sohams-MASS/AVCC_Electronics/AVCC_Architecture.pdf

# AVCC Electronics System Architecture

Detailed Technical Reference

Platform: ESP32 (Espressif, Arduino Core 2.0.14 / ESP-IDF 5.x) Protocol: ESP-NOW (250 kbps, 250 byte max payload) Topology: 1 Master + 3 Slaves (star)
Channels: 12 per slave (36 total outputs)

Generated March 8, 2026

AVCC Electronics | System Architecture

## Contents

1 System Overview | 2
2 Wire Protocol | 3
3 Master Controller | 4
4 Electrical Slave | 7
5 Pressure Slave | 10
6 Servo Slave | 11
7 Synchronization and Timing | 13

8 Safety Mechanisms | 14
9 Memory and Performance | 14
10 Utility Sketches | 15
11 Complete File Reference | 15
12 Appendix: MAC Addresses (Current Configuration) | 15

## 1 System Overview

The AVCC (Autonomous Vascular Compression Controller) Electronics system is a real-time, wireless, multi-channel waveform controller built on four ESP32 microcontrollers connected via ESP-NOW. It drives three different output modalities—analog voltage (electrical), digital solenoid (pressure), and servo motor—synchronized from a single master controller.

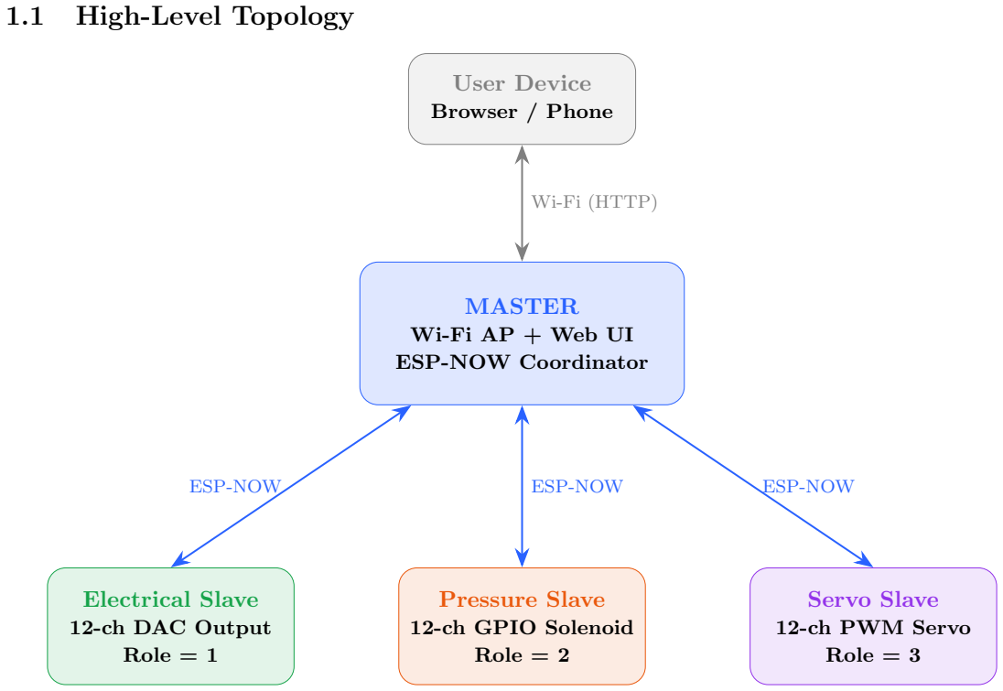
[picture p1: figure]
1.1 High-Level Topology; MASTER; Wi-Fi AP + Web UI ESP-NOW Coordinator; Electrical Slave; 12-ch DAC Output; Role = 1; Pressure Slave; 12-ch GPIO Solenoid Role = 2; Servo Slave; 12-ch PWM Servo Role = 3; ESP-NOW; User Device; Browser / Phone; Wi-Fi (HTTP)

### 1.2 Communication Flow Summary

1. User connects to the Master’s Wi-Fi AP (AVCC Master 5, password 12345678) and opens http://192.168.4.1.
2. Master serves a streamed HTML control page where the user configures 12 channels (frequency, pulse width, amplitude, pressure duration, phase offsets).
3. On Apply + Start, the Master enters the MS WAIT ACKS state, burst-sends CMD SET messages for all 12 channels to all 3 slaves, followed by targeted CMD START messages.
4. Each Slave receives messages via a FreeRTOS queue, applies per-channel configuration, and sends back AckMsg (0xA1) confirmations.
5. During operation (MS RUNNING), the Master sends CMD KEEPALIVE at 6.7 Hz. Slaves auto-stop if no keepalive arrives within 500 ms.
6. Slaves send StatusMsg (0xA2) at 1 Hz with health telemetry (heap, heartbeat age, sequence watermark).

## 2 Wire Protocol

All messages are sent as raw ESP-NOW payloads. Structs use attribute ((packed)) to eliminate padding and guarantee byte-exact layout across devices.

### 2.1 Command Message (Msg) — Master → Slaves

Field | Type | Offset | Description
cmd | uint8 t | 0 | Command code (1–4)
ch | uint8 t | 1 | Channel 1–12 (0 = all)
flags | uint8 t | 2 | Bitfield (see below)
neutral code | uint8 t | 3 | DAC neutral code (0x80)
run id | uint32 t | 4 | Monotonic run identifier
seq | uint32 t | 8 | Per-channel sequence number
period us | uint32 t | 12 | Full cycle period (µs)
pulse us | uint32 t | 16 | Pulse width (µs)
pos code | uint8 t | 20 | Positive DAC code
neg code | uint8 t | 21 | Negative DAC code
rsv0 | uint8 t | 22 | Reserved
rsv1 | uint8 t | 23 | Reserved
start delay us | uint32 t | 24 | Sync start delay (µs)
phase offset us | uint32 t | 28 | Phase offset (µs)
duration ms | uint32 t | 32 | Run duration (ms); 0 = forever

Total size: 36 bytes (V3). The legacy V1 format is 24 bytes (no start delay us, phase offset us, duration ms). Pressure and Servo slaves auto-detect V1 by checking len == sizeof(MsgV1).

### 2.1.1 Command Codes

Value | Name | Description
1 | CMD SET | Configure channel parameters (period, pulse,
amplitude). Does not start output.
2 | CMD START | Begin waveform output. | Carries start delay,
phase offset, and duration.
3 | CMD STOP | Immediately stop all channels and park outputs
at safe state.
4 | CMD KEEPALIVE | Heartbeat ping. | Resets each slave’s failsafe
timer.

### 2.1.2 Flag Bits

Bit | Constant | Meaning
0 | FLG SET MIRROR (0x01) Mirror waveform around neutral (electrical only)
1 | FLG TGT ELEC (0x02) | START targets the Electrical slave
2 | FLG TGT PRES (0x04) | START targets the Pressure slave
3 | FLG TGT MOTO (0x08) | START targets the Servo slave

### 2.2 Acknowledgment Message (AckMsg) — Slaves → Master

Field | Type | Offset | Description
type | uint8 t | 0 | Always 0xA1
role | uint8 t | 1 | 1=Electrical, 2=Pressure, 3=Motor
cmd | uint8 t | 2 | Echoed command code
ch | uint8 t | 3 | Echoed channel (0 for STOP)
run id | uint32 t | 4 | Echoed run ID
seq | uint32 t | 8 | Echoed sequence number
ok | uint8 t | 12 | 1 = accepted, 0 = rejected
rsv[3] uint8 t | 13 | Reserved padding

Total size: 16 bytes.

### 2.3 Status Message (StatusMsg) — Slaves → Master

Field | Type | Offset | Description
type | uint8 t | 0 | Always 0xA2
role | uint8 t | 1 | Slave role identifier
rsv0, rsv1 | uint8 t | 2 | Reserved
millis now | uint32 t | 4 | Slave’s millis() timestamp
run id | uint32 t | 8 | Current run ID on slave
last seq max | uint32 t | 12 | Highest sequence number seen
hb age ms | uint16 t | 16 | Keepalive age (ms), capped at 65535
free heap | uint16 t | 18 | Free heap (bytes), capped at 65535

Total size: 20 bytes. Sent at 1 Hz by each slave.

### 2.4 Sequence Guard Mechanism

Each slave maintains a per-channel sequence counter lastSeq[12]. When a CMD SET or CMD START arrives, the slave checks:

1 | static inline bool acceptSeq(uint8_t idx0, const Msg &m) {
2 | if (m.seq <= lastSeq[idx0]) return false; // stale -> reject
3 | lastSeq[idx0] = m.seq;
4 | if (m.seq > lastSeqMax) lastSeqMax = m.seq;
5 | return true;
6 | }

When a new run id is detected (master restarted), all sequence counters are reset to 0 so fresh commands are accepted.

## 3 Master Controller

File: Master Pressure Servo Electrical.ino (1049 lines)

### 3.1 Wi-Fi and Web Server

The Master runs in WIFI AP mode (not AP STA) to avoid radio instability on ESP-IDF 5.x. It creates a soft access point:

Parameter | Value
SSID | AVCC Master 5
Password | 12345678
Channel | 1
Max clients | 4
IP address | 192.168.4.1

The web server uses streamed HTML (chunked transfer encoding) via server.sendContent() to avoid heap-killing String concatenation. All HTML is built with stack-allocated char buf[] arrays and snprintf().
WEBSERVER MAX POST ARGS is set to 100 (default 32) because the form has 12 × 7 = 84 channel fields plus control buttons.

### 3.1.1 HTTP Endpoints

Method | Path | Handler
GET | / | handleRoot() – serve control page
POST | /apply | handleApply() – apply/start/stop
POST | /save | handleSave() – save to NVS flash
POST | /load | handleLoad() – reload from NVS
POST | /factory | handleFactory() – factory defaults (RAM)
POST | /factory save | handleFactorySave() – factory + save
GET | /favicon.ico | handleFavicon() – 204 No Content

### 3.2 NVS Persistent Storage

Settings are stored in the ESP32’s Non-Volatile Storage (NVS) partition under namespace "avcc". Per-channel keys use a compact naming scheme:

Key pattern | Type | Content
en%02d | Bool | Channel enable
f%02d | Float | Frequency (Hz)
pu%02d | UInt | Pulse width (µs)
a%02d | Float | Amplitude (V)
pd%02d | UInt | Pressure duration (ms)
pp%02d | UInt | Pressure phase offset (µs)
mp%02d | UInt | Motor phase offset (µs)
dbg | Bool | Debug serial output
boot | Bool | Boot auto-start

### 3.3 Master State Machine

The Master uses an explicit three-state machine to manage the apply/start/stop lifecycle:

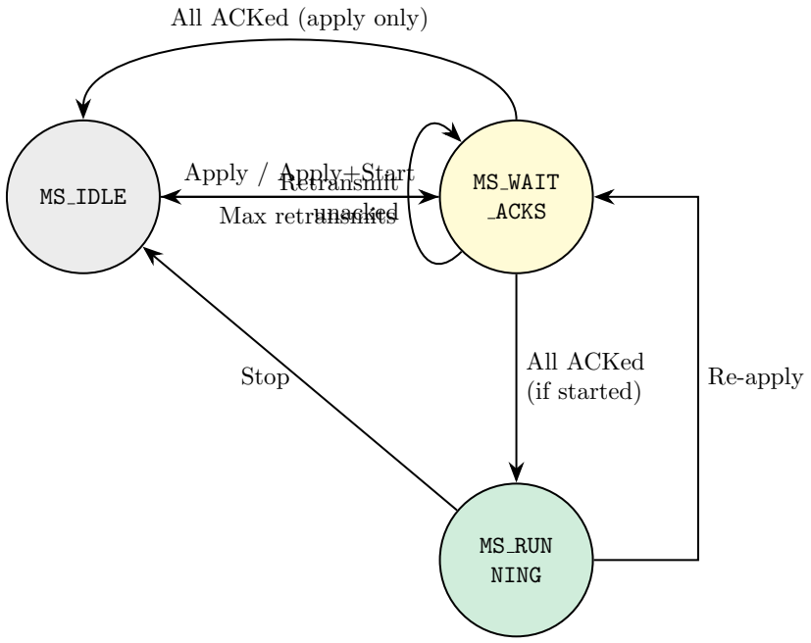
[picture p2: figure]
MS IDLE; MS WAIT; ACKS; MS RUN NING; Apply / Apply+Start; All ACKed (if started); All ACKed (apply only); Max retransmits; Stop; Re-apply; Retransmit unacked

Listing 1: Master state types

1 | enum MasterState : uint8_t {
2 | MS_IDLE, | // waiting for user input
3 | MS_WAIT_ACKS, // sent SETs (and maybe STARTs), waiting for ACKs
4 | MS_RUNNING | // all channels active, sending keepalives
5 | };

6
7 | enum RequestType : uint8_t {
8 | REQ_APPLY_ONLY, // send SETs only, return to IDLE
9 | REQ_APPLY_START, // send SETs + STARTs, transition to RUNNING
10 | REQ_STOP | // send STOP, return to IDLE
11 | };

12
13 | struct PendingRequest {
14 | RequestType type;
15 | bool valid = false;
16 | };

### 3.4 Burst Send Architecture

Instead of sending one channel per loop() iteration (the old applyOneStep() pattern), the Master now sends all 12 channels in a single burst:

1. burstAllSets() — Iterates over all 12 channels. For each enabled channel, increments its sequence number, constructs a CMD SET message, sends it to all 3 slaves via sendSetToAll(), and sets the corresponding bit in unackedBitmap[3]. Calls yield() after each channel to let the ESP-NOW TX queue drain.
2. burstAllStarts() — For each enabled channel, sends 3 targeted CMD START messages (one per slave) with appropriate flags, phase offset us, and duration ms. Each message gets a fresh sequence number.

### 3.5 Targeted Retransmission

The Master tracks acknowledgments per-slave, per-channel:

1 | struct SlaveHealth {
2 | uint32_t ackSeqCh[12]; // last acked seq per channel
3 | uint32_t expSeqCh[12]; // expected seq per channel
4 | // ...health telemetry...
5 | };
6 | SlaveHealth H[3]; // S_ELEC=0, S_PRES=1, S_MOTO=2
7 | uint16_t unackedBitmap[3]; // per-slave bitmask of unacked channels

retransmitUnacked() only re-sends CMD SET messages to slaves that haven’t acknowledged specific channels, rather than broadcasting to all. Up to MAX RETRANSMITS = 3 retries are attempted at 600 ms intervals.

### 3.6 Keepalive

When running == true, the Master sends CMD KEEPALIVE to all 3 slaves every 150 ms (≈6.7 Hz). This rate is deliberately lower than the original 20 Hz to reduce congestion with 3 slaves.

### 3.7 Per-Channel Settings

Each of the 12 channels has:

Parameter | Range | Default
Frequency (Hz) | 0.01–10 | 0.5
Pulse width (µs) | 50–T /2 | 2000
Amplitude (V) | 0–15 | 15.0
Pressure duration (ms) | 0+ | 330
Pressure phase offset (µs) 0+ | 0
Motor phase offset (µs) | 0+ | 0
Enable | bool | true

The amplitude is converted to an 8-bit DAC code using:

code = round | V + 15
| 30

× 255

where V ∈ [−15, +15] volts, giving code 0x00 for −15 V and 0xFF for +15 V, with 0x80 as the neutral midpoint.

## 4 Electrical Slave

File: Electrical Receiver V2.ino (755 lines)
This slave generates bipolar analog waveforms on 12 channels via an 8-bit parallel DAC bus. It is the most architecturally complex slave due to its dual-task design.

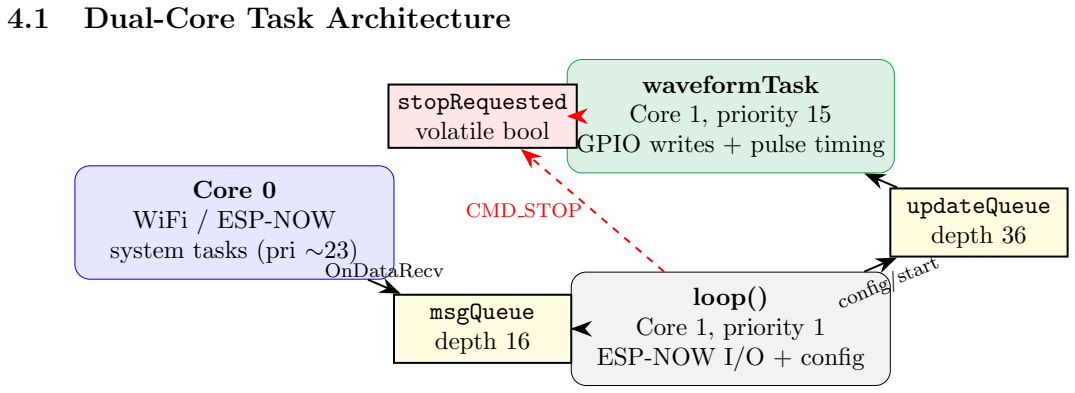
[picture p3: figure]
4.1 Dual-Core Task Architecture; Core 0 WiFi / ESP-NOW system tasks (pri ∼23); waveformTask Core 1, priority 15 GPIO writes + pulse timing; loop() Core 1, priority 1 ESP-NOW I/O + config; msgQueue depth 16; updateQueue depth 36; stopRequested volatile bool; OnDataRecv; config/start; CMD STOP

- Core 0 runs WiFi and ESP-NOW system tasks at priority ∼23. The OnDataRecv callback executes here but only enqueues packets into msgQueue—no processing.
- Core 1 hosts two tasks:

– waveformTask (priority 15): owns all GPIO writes, the pulse scheduler, and the ChanState[12] array. Spin-waits when the next edge is < 500 µs away for submillisecond timing precision.

– loop() (priority 1): handles all ESP-NOW I/O (receive, ACK, status), config parsing, and cross-task communication via updateQueue.

### 4.1.1 Adaptive Yield Strategy

waveformTask dynamically adjusts its yield behavior based on the time until the next scheduled edge:

Gap to next edge | Action | Rationale
≤ 500 µs | Spin-wait (no yield) | Sub-ms critical window
500 µs – 2 ms | taskYIELD() | Brief reschedule
2 ms – 5 ms | vTaskDelay(1) | One FreeRTOS tick
> 5 ms | vTaskDelay(gap−2ms) Long sleep
No active channels | vTaskDelay(10) | Deep idle

### 4.2 DAC Hardware Interface

The Electrical slave drives 12 DAC channels through 3 quad-DAC chips connected via an 8-bit parallel data bus:

### 4.2.1 Pin Mapping

Signal | GPIO(s) | Purpose
DB0–DB7 | 16, 15, 14, 13, 12, 5, 4, 2 | 8-bit data bus
DAC SEL0 | 17 | DAC channel select bit 0
DAC SEL1 | 18 | DAC channel select bit 1
WR1 | 23 | Write strobe, chip 1 (ch 1–4)
WR2 | 25 | Write strobe, chip 2 (ch 5–8)
WR3 | 26 | Write strobe, chip 3 (ch 9–12)

### 4.2.2 Write Sequence

To set a channel’s DAC output:

1. Apply logical-to-physical channel remapping (swaps channels 2↔3, 6↔7, 10↔11).
2. Write the 8-bit code to the data bus using direct GPIO register writes (GPIO.out w1tc / GPIO.out w1ts).
3. Wait 1 µs (data setup time).
4. Set the DAC select lines (2-bit address within chip).
5. Wait 1 µs (select setup time).
6. Strobe the appropriate WR pin LOW for 2 µs, then HIGH (latch).

Total write time: ≈4–5 µs per channel update.

### 4.3 Per-Channel State Machine

Each electrical channel follows a 5-state machine for bipolar waveform generation:

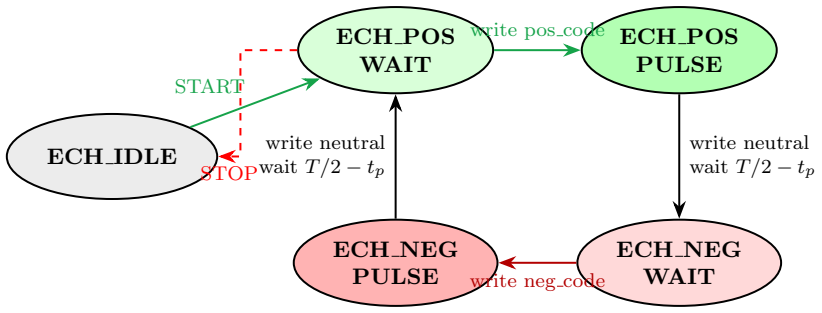
[picture p4: figure]
ECH IDLE; ECH POS WAIT; ECH POS PULSE; ECH NEG WAIT; ECH NEG PULSE; START; write pos code; write neutral wait T /2 − tp; write neg code; write neutral STOPwait T /2 − tp

Listing 2: Electrical channel state enum

1 | enum ElecChState : uint8_t {
2 | ECH_IDLE, | // channel disabled
3 | ECH_POS_WAIT, // waiting for positive pulse edge
4 | ECH_POS_PULSE, // positive pulse active (DAC = pos_code)
5 | ECH_NEG_WAIT, // waiting for negative pulse edge
6 | ECH_NEG_PULSE // negative pulse active (DAC = neg_code)

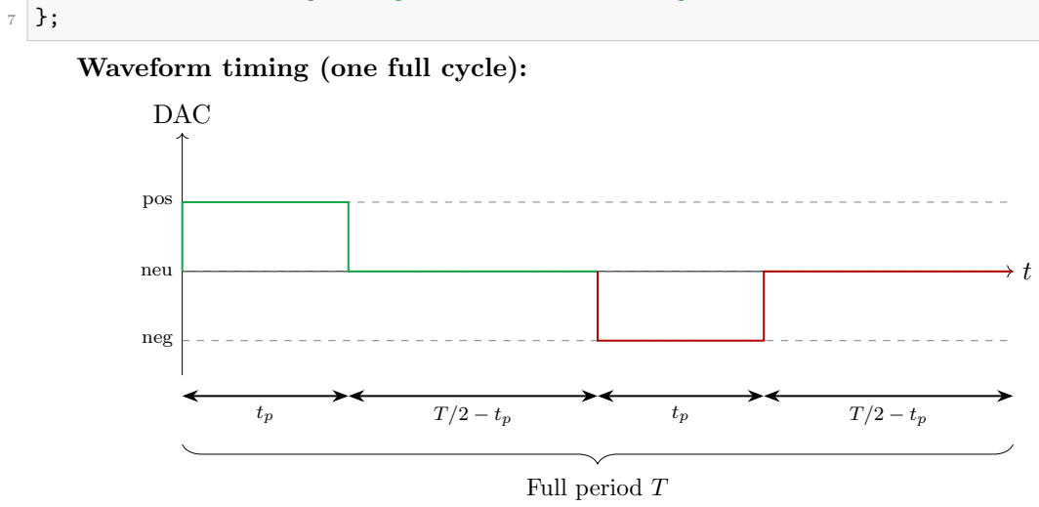
[picture p5: figure]
Waveform timing (one full cycle):; DAC; pos; neu; neg; Full period T

Where tp = pulse us and T = period us.

### 4.4 Inter-Task Communication

Queue | Direction | Depth | Payload
msgQueue | ESP-NOW CB → loop() | 16 | RxPacket: 6-byte MAC + 36- byte Msg
updateQueue | loop() | →
| waveformTask
36 | ChanUpdate: | type + channel
| | | config + nextEdge
stopRequested | loop() | →
| waveformTask

1 (flag) volatile bool

### 4.5 Timing Constants

Constant | Value | Purpose
MIN PULSE US | 50 µs | Minimum pulse width
MIN PERIOD US | 100 ms | Maximum frequency (10 Hz)
MAX PERIOD US | 30 s | Minimum frequency (0.033 Hz)
HEARTBEAT TIMEOUT MS | 500 ms | Failsafe timeout
STATUS PERIOD MS | 1000 ms | Health report interval
MAX EVENTS PER BURST | 400 | Scheduler burst limit

## 5 Pressure Slave

File: Pressure Receiver V2.ino (506 lines)
This slave controls 12 solenoid valves via digital GPIO outputs. It generates a square wave by toggling each output HIGH/LOW at a rate of two pulses per full electrical period (one pulse per half-cycle).

### 5.1 GPIO Pin Mapping

CH1 | CH2 | CH3 | CH4 | CH5 | CH6 | CH7 | CH8 | CH9 | CH10 | CH11 | CH12
19 | 14 | 15 | 23 | 25 | 26 | 0 | 2 | 4 | 5 | 12 | 13

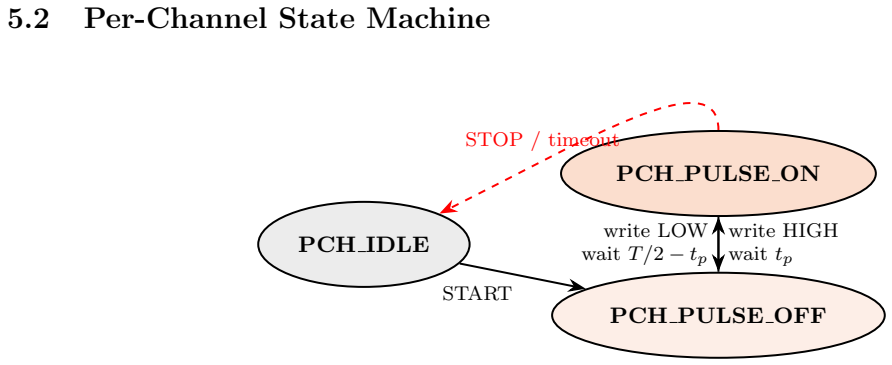
[picture p6: figure]
5.2 Per-Channel State Machine; PCH IDLE; PCH PULSE ON; PCH PULSE OFF; START; write HIGH wait tp; write LOW wait T /2 − tp; STOP / timeout

Listing 3: Pressure channel state enum

1 | enum PressChState : uint8_t {
2 | PCH_IDLE, | // disabled or not started
3 | PCH_PULSE_ON, // output HIGH (pulse active)
4 | PCH_PULSE_OFF // output LOW (off-portion of half-cycle)

5 };

### 5.3 Duration Auto-Stop

Each channel has a stopAt ms field. When duration ms is non-zero in the CMD START message, the slave computes stopAt ms = millis() + duration ms. Each loop() iteration checks for expired channels:

1 | if (chs[i].chState != PCH_IDLE &&
2 | chs[i].stopAt_ms != 0 &&
3 | (int32_t)(nowms - chs[i].stopAt_ms) >= 0) {
4 | chs[i].chState = PCH_IDLE;
5 | writePressure(i+1, false);
6 | }

### 5.4 FreeRTOS Message Queue

The Pressure slave uses a FreeRTOS queue (depth 16) to safely pass messages from the ESP-NOW receive callback to the main loop, preventing packet drops during the Master’s burst send of 12 channels:

1 | struct RxPacket { uint8_t mac[6]; Msg msg; };
2 | static QueueHandle_t msgQueue = nullptr;
3 | static const int MSG_QUEUE_DEPTH = 16;

The callback (OnDataRecv) also supports backward-compatible V1 messages by detecting len == sizeof(MsgV1) and zero-filling the V3 extension fields.

### 5.5 Architecture Differences from Electrical

Aspect | Electrical | Pressure
Threading | Dual-task (waveformTask + loop) Single-task (loop only)
Output | 8-bit DAC (analog) | Digital GPIO (HIGH/LOW)
Pulses/cycle | 2 (bipolar: pos + neg) | 2 (both HIGH)
Stop method | stopRequested flag | Direct safeStopAll()
Duration | Not supported | Per-channel auto-stop

## 6 Servo Slave

File: Servo Receiver V2.ino (494 lines)
This slave drives 12 hobby servo motors with a ramp-up/ramp-down motion profile. It has a 2 Hz hard frequency cap to protect the mechanical servos.

### 6.1 GPIO Pin Mapping

Same physical pins as the Pressure slave:

CH1 | CH2 | CH3 | CH4 | CH5 | CH6 | CH7 | CH8 | CH9 | CH10 | CH11 | CH12
19 | 14 | 15 | 23 | 25 | 26 | 0 | 2 | 4 | 5 | 12 | 13

### 6.2 Motion Profile

t

degrees

30°

60°

UP: 11ms/deg | DOWN: 3.67ms/deg
Parameter | Value | Description
DEG MIN | 30° | Motion start/end angle
DEG MAX | 60° | Motion peak angle
UP STEP US | 11 000 µs | Time per degree during ramp-up
DOWN STEP US | 3 667 µs | Time per degree during ramp-down
Range | 30° | Total sweep = 30 degrees
Up time | ∼330 ms | 30 × 11 ms
Down time | ∼110 ms | 30 × 3.67 ms

### 6.3 Per-Channel State Machine

ST IDLE

ST UP

ST DOWN

cycle boundary

reached DEG MAX

reached DEG MIN

The servo uses the existing MotionStage enum (unchanged from the original design):

1 | enum MotionStage : uint8_t {
2 | ST_IDLE = 0,
3 | ST_UP | = 1,
4 | ST_DOWN = 2
5 | };

6.4 2 Hz Hard Cap

If the configured frequency exceeds 2 Hz (period us < 500000), the channel is disabled and the CMD START ACK is sent with ok = 0 (rejected). This protects the servo mechanism from being driven faster than it can physically respond.

### 6.5 Cycle Boundary Logic

Unlike the Electrical and Pressure slaves which schedule edge events via nextEdge us, the Servo slave uses a two-level scheduler:

1. Cycle boundary: Each channel has a nextCycle us timestamp. When the current time passes this boundary, a new motion cycle is triggered (if the channel is idle) by calling startMotion().
2. Step scheduler: Within a motion cycle, each channel has a nextStep us timestamp. The servo angle is incremented/decremented by 1° at each step event.

## 7 Synchronization and Timing

### 7.1 Start Delay and Phase Offset

When the Master sends CMD START, each slave computes its first edge as:

nextEdge us = micros() + start delay us + phase offset us

- start delay us is a global constant (600 ms default) that gives all slaves time to receive and process their START messages before any output begins.
- phase offset us is per-channel, per-slave, allowing the user to shift pressure and motor outputs relative to the electrical waveform.

### 7.2 Keepalive Failsafe

All 3 slaves implement the same heartbeat failsafe:

Parameter | Value
Master send rate | Every 150 ms (∼6.7 Hz)
Slave timeout | 500 ms (∼3 missed keepalives)
Action on timeout | safeStopAll() — all outputs to safe state

Implementation difference: The Electrical slave cannot call safeStopAll() directly from loop() because that function writes to GPIOs owned by waveformTask on the same core at priority 15. Instead, it sets stopRequested = true and the waveform task checks this flag at the top of each iteration. Pressure and Servo slaves are single-threaded, so they call safeStopAll() directly.

### 7.3 Peer Management

Master (AP mode): Adds all 3 slave MACs as peers at startup using WIFI IF AP interface. Channel is set to 0 (use current).
Slaves (STA mode): Dynamically add the Master as a peer when they receive the first packet. The Master’s MAC is extracted from the esp now recv info t in the receive callback. A send-failure backoff mechanism re-registers the peer after 3 consecutive esp now send failures:
1 | static inline void trackSendResult(esp_err_t e) {
2 | if (e == ESP_OK) { sendFailCount = 0; }
3 | else { if (++sendFailCount >= 3) masterPeerAdded = false; }
4 | }

## 8 Safety Mechanisms

### 8.1 Failsafe Summary

Mechanism | Description
Heartbeat timeout | 500 ms without keepalive → all outputs to safe
| state
Sequence guard | Per-channel | monotonic | sequence | rejects
stale/duplicate packets
Run ID reset | New run id resets all sequence counters to ac-
cept fresh commands
Timing guardrails | Period clamped to [100 ms, 30 s]; pulse clamped
| to [50 µs, T /2]
Servo hard cap | Frequencies > 2 Hz rejected; channel disabled
Peer re-registration | 3 send failures → peer deleted and re-added
Duration auto-stop | Pressure channels auto-stop after configured du-
| ration
Event burst limit | Max 400 events per scheduler iteration (prevents
| infinite loops)

### 8.2 Safe Stop Behavior

Slave | Safe stop action
Electrical | All 12 DAC channels set to neutral code (0x80 = 0 V)
Pressure | All 12 GPIO outputs set LOW (solenoids off)
Servo | All 12 servos driven to DEG MIN (30°)

## 9 Memory and Performance

### 9.1 Web Server Heap Management

The Master’s web UI avoids dynamic String allocation entirely. All HTML is generated using stack-allocated char buf[] arrays with snprintf() and streamed via server.sendContent().
The Connection: close header and explicit server.client().stop() ensure TCP sockets
are released promptly.
The master dashboard displays real-time heap metrics (ESP.getFreeHeap() and ESP.getMaxAllocHeap()) for monitoring memory health.

### 9.2 Queue Sizing

Queue | Depth | Item size | Device
msgQueue (Electrical) | 16 | 42 B | Electrical slave
updateQueue | 36 | ∼28 B | Electrical slave
msgQueue (Pressure) | 16 | 42 B | Pressure slave
msgQueue (Servo) | 16 | 42 B | Servo slave

The queue depth of 16 accommodates the Master’s burst of 12 CMD SET messages (one per channel) plus headroom for keepalives arriving during processing. The Electrical slave’s updateQueue has depth 36 (12 × 3) to hold 12 CONFIG + 12 START updates plus 12 spare.

## 10 Utility Sketches

### 10.1 BICEP MAC Address

A simple utility sketch that prints the ESP32’s MAC address to Serial at 300 baud. Used during initial hardware provisioning to discover each board’s MAC address for the Master’s peer table.

1 | void setup(){
2 | Serial.begin(300);
3 | Serial.print("ESP Board MAC Address: ");
4 | Serial.println(WiFi.macAddress());
5 | }

### 10.2 Test on Wifi

A diagnostic sketch that creates a Wi-Fi AP and confirms the ESP32’s radio is functional. Used for hardware bring-up testing.

## 11 Complete File Reference

File | Lines | Role
Master Pressure Servo Electrical.ino 1049 | Central controller: | Wi-Fi AP,
Web UI, ESP-NOW coordinator,
| | state machine
Electrical Receiver V2.ino | 755 | Electrical slave: 12-ch DAC out-
put, dual-task architecture, sub-
| | ms timing
Pressure Receiver V2.ino | 506 | Pressure slave: | 12-ch GPIO
solenoid control, duration auto-
| | stop
Servo Receiver V2.ino | 494 | Servo slave: 12-ch servo motor,
ramp profile, 2 Hz hard cap
BICEP MAC Address.ino | 16 | Utility: print ESP32 MAC ad-
| | dress
Test on Wifi.ino | — | Utility: Wi-Fi AP smoke test

## 12 Appendix: MAC Addresses (Current Configuration)

Device | MAC Address | Variable
Electrical slave | 94:54:C5:74:AB:38 | mac elec[]
Pressure slave | 68:FE:71:0C:B9:50 | mac press[]
Servo slave | 68:FE:71:0C:B7:F8 | mac motor[]
