sohams-MASS/AVCC_Electronics/(commit log)

2026-04-25 Initial commit: AVCC Electronics
    ESP32-based 4-node system (1 master + 3 slaves over ESP-NOW) for
    12-channel waveform output: electrical (DAC), pressure (solenoid),
    and servo. Includes architecture spec (LaTeX + PDF), Arduino
    sketches for each node, and MAC-address utility.
2026-04-25 Fix MAC sketch zero output and clean up folder naming
    - BICEP_MAC_Address: set WIFI_STA mode before reading MAC (was returning
    00:00:00:00:00:00 because radio wasn't initialized)
    - Bump baud 300 -> 115200 to match the rest of the codebase
    - Drop ESP8266 branch (project is ESP32-only)
    - Move sketch out of "BICEP_MAC_Address (1)/" into Arduino-compliant
    BICEP_MAC_Address/ (folder name must match .ino name, no spaces/parens)
    - Update CLAUDE.md utility entry
    [BICEP_MAC_Address.ino]
2026-04-25 Move MasterState/SlaveIdx enums above auto-prototype point
    Arduino IDE inserts forward function prototypes near the top of the
    .ino, before the original locations of these enums. Functions taking
    SlaveIdx or MasterState as parameters then failed to compile because
    their auto-generated prototypes referenced undefined types. Moving
    the enum definitions to right after the includes makes the prototypes
    resolvable.
    [Master_Pressure_Servo_Electrical.ino]
2026-04-25 Forward-declare ChanState/ChanUpdate for Arduino auto-prototypes
    Same auto-prototype trap as the master sketch: clampTiming() and
    applyUpdate() take ChanState/ChanUpdate by reference, but those
    struct definitions live below the function definitions. The IDE's
    auto-generated prototypes then fail to compile because the type
    names aren't yet in scope. Pass-by-reference only needs the name,
    so a forward declaration is sufficient — and avoids reshuffling
    the struct definitions above the constants they default-initialize
    from (DEF_NEU/DEF_POS/DEF_NEG).
    [Electrical_Receiver_V2.ino]
2026-04-25 Throttle slave ack burst to fix stuck "pending channel"
    Apply+Start sends 12 SETs + 12 STARTs back-to-back. Each slave drained
    all 24 in a tight while-loop and called esp_now_send for every ack
    inside dispatchMsg. ESP-NOW's send queue is 10 deep, so the last few
    acks failed with ESP_ERR_ESPNOW_NO_MEM and were silently dropped —
    master then saw ackSeqCh < expSeqCh forever for those channels and
    the UI showed them "pending" indefinitely (keepalives don't carry
    per-channel acks, so the count never recovers).
    Adding vTaskDelay(1) after each dispatchMsg paces ack submission to
    ~1 kHz, well below the radio drain rate.
    [Electrical_Receiver_V2.ino, Pressure_Receiver_V2.ino, Servo_Receiver_V2.ino]
2026-04-25 Add standalone Electrical sketches (test + Wi-Fi GUI)
    Electrical_Standalone_Test: hardcoded 12-channel sweep (0.5 Hz, pulse
    widths 2000..13000 µs) with no Wi-Fi or ESP-NOW. Verifies the analog
    front end is wired and pulsing correctly before the wireless layer
    is brought online.
    Electrical_Standalone_WiFi: single-board UI variant. Hosts its own
    soft-AP "Saumel_Electrical" and serves a streamed-HTML form at
    http://192.168.4.1 with per-channel enable / Hz / pulse / amp (V).
    Channels are independent and re-arm phase-aligned on Apply. Mirrors
    Electrical_Receiver_V2's dual-task architecture (waveformTask owns
    DAC; loop() runs the web server) so Wi-Fi traffic can't starve
    sub-ms pulse timing.
    Co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
    [Electrical_Standalone_Test.ino, Electrical_Standalone_WiFi.ino]
2026-04-25 Forward-declare ApplyMsg for Arduino auto-prototypes
    applyMessage() takes ApplyMsg by reference, but the struct is defined
    below the function. The IDE's auto-generated prototype near the top
    of the .ino then can't resolve the type. Pass-by-reference only needs
    the name, so a forward declaration is sufficient.
    [Electrical_Standalone_WiFi.ino]
2026-04-25 Add NVS save/load/factory to standalone Wi-Fi sketch
    Persists per-channel enable / Hz / pulse / amp to NVS, mirroring the
    master's pattern but in its own "saumel_el" namespace so a chip
    that's been used for both sketches doesn't get key collisions.
    UI gains three buttons:
    - Save: writes the last-applied RAM config to flash. Form fields
    posted with this request are intentionally ignored — Save is
    decoupled from form edits so a typo can't reach flash without
    going through Apply first.
    - Load: pulls the saved config back into RAM and re-renders the
    form with those values. Running channels are untouched until the
    user presses Apply.
    - Factory Reset: rewrites RAM with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
    [Electrical_Standalone_WiFi.ino]
2026-04-25 Loosen abort thresholds and lengthen slave heartbeat
    Symptom: master shows Electrical OK and "running" but no DAC output.
    Root cause was the slaves' local 500 ms heartbeat watchdog firing
    during MS_WAIT_ACKS — the first keepalive doesn't arrive until ~230
    ms after Apply+Start (master cadence 150 ms, lastKeepMs set after
    the burst), and any drain stall puts the slave past 500 ms before
    its first edge would have fired at +600 ms.
    Three fixes:
    1. Master: revert the Tier-1-B "abort on Electrical SET unacked"
    path back to "proceed anyway". The strict abort was tearing down
    runs on any single radio drop. Slave-side guardrails (clamp,
    run_id check) still protect against truly out-of-sp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
    [Electrical_Receiver_V2.ino, Master_Pressure_Servo_Electrical.ino, Pressure_Receiver_V2.ino, Servo_Receiver_V2.ino]
2026-04-25 Retry on master TX queue overflow; bump slave RX queue depth
    Symptom: 3-4 channels stuck pending after Apply+Start, no DAC output.
    Root cause: ESP-NOW driver's send queue is only 10 deep on the master.
    burstAllSets and burstAllStarts each submit ~36 packets in well under a
    millisecond, so several silently fail with ESP_ERR_ESPNOW_NO_MEM and
    the slave never receives them. yield() between channel iterations
    doesn't help because the radio task is on core 0 — yielding on core 1
    doesn't pace submission.
    Master sendOne: retry up to 6 times on NO_MEM with vTaskDelay(1)
    backoff (~one packet airtime per retry). On success it returns
    immediately, so traffic that fits in the queue isn't slowed.
    Al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
    [Electrical_Receiver_V2.ino, Master_Pressure_Servo_Electrical.ino, Pressure_Receiver_V2.ino, Servo_Receiver_V2.ino]
